OpenDrone-hw/OpenRX-Lite-UFL/(commit log)

2026-03-23 Add SolderPad_1.2x2.0mm with 25% rounded corners, 2.0mm pitch standard
2026-03-23 Import SKY13588-460LF SP3T RF switch (C2151906) into shared library
2026-03-23 Final topology: Mono + Gemini netlist with SKY13588 RF switch
    - SKY13588-460LF imported into shared library
    - Complete netlist for Mono (1×LR1121 + SKY13588 + Johanson IPD + DEA LPF → 1 UFL)
    - Gemini = 2× Mono RF chains + ESP32-C3 True Diversity GPIO mapping
    - GPIO maps match official ELRS Generic C3 LR1121 and True Diversity targets
    - Routing notes for RF paths included
    - Mono needs complete GPIO rewire to match ELRS target
2026-03-23 FINAL_NETLIST v3: SKY13588 as band combiner, RFX2401C kept for 100mW
    Based on RadioMaster XR4 teardown analysis:
    - SKY13588 serves as both sub-GHz path switch AND band combiner
    - Johanson IPD in direct-tie mode (RX/TX_LP/TX_HP joined) → SKY13588 J1
    - 2.4GHz: RFIO_HF → DEA LPF → RFX2401C → SKY13588 J2
    - SKY13588 RFC → DC block → UFL → dual-band antenna
    - RFX2401C kept for 100mW market parity
    - Button imported (C2976675, 3x2mm SMD)
    - RFSW truth table: DIO7/DIO8 control band, DIO5/DIO6 control RFX2401C
2026-03-24 Repo cleanup: final state for handoff
    - Clean README with architecture, BOM, CE notes, status
    - Remove dated analysis files (absorbed into FINAL_NETLIST + KICAD_WORKFLOW)
    - Remove stale OpenRX-Dual (archived), ERC reports, backups, prl files
    - Updated .gitignore for .kicad_dru, production backups
    - CERN-OHL-S v2 license confirmed
    - 3 active projects: Lite, Mono, Gemini
    - Schematics final, initial PCB layouts done, routing in progress
2026-04-06 Update schematics: Mono RF rewiring, SKY13414 port mapping, shared libs
    Mono: disconnect IPD TX_LP (unused by ELRS), route TX_HP→RF3, RX→RF1,
    RFX2401C ANT→RF4. Matches BetaFPV SuperX topology.
2026-04-06 Add Lite-UFL variant, ELRS targets, new footprints and 3D models
    - OpenRX-Lite-UFL: UFL antenna variant of Lite ceramic
    - ELRS target JSONs: Lite 2400, Mono LR1121, Gemini LR1121
    - radio_rfsw_ctrl: [15,0,0,8,8,14,0,13] for Mono/Gemini
    - SKY13414 QFN-14 footprint + 3D model
    - 2450FM07D0034 filter footprint
    - BOM LCSC passives script
    [OpenRX-Lite-UFL.kicad_pcb, OpenRX-Lite-UFL.kicad_sch, esp32c3_sx1281_lite.kicad_sch]
2026-04-06 Add component datasheets and BOM index
    Local datasheet cache for all active RF components: LR1121, SX1281,
    SKY13414, SKY13373, RFX2401C, 2450FM07D0034, 0900PC16J0042001E,
    2000PC15C0040001E, 2450AT18A100E, BALF-SPI2-01D3, passives.
2026-04-06 Update all DESIGN.md docs: RF paths, GPIO maps, rfsw_ctrl, known bugs
    - Mono: new SKY13414 port mapping (RF1=RX, RF3=TX_HP, RF4=2.4GHz),
    rfsw_ctrl [15,0,0,8,8,14,0,13], GPIO map, impedance notes
    - Lite/Lite-UFL: GPIO map, no-boot-button note, SPI pin difference
    - Gemini: document DIO7-2/DIO8-2 wiring bug, stale component list
    - README: current lineup table
2026-04-21 initial routing for all
    [OpenRX-Lite-UFL.kicad_pcb, esp32c3_sx1281_lite.kicad_sch]
2026-04-27 final route
    [OpenRX-Lite-UFL.kicad_pcb]
2026-04-28 Set via netclass + dimension defaults to 0.3/0.2mm on all 4 boards
    [OpenRX-Lite-UFL.kicad_pcb]
2026-04-28 switch to 0.2mm vias
    [OpenRX-Lite-UFL.kicad_pcb]
2026-04-28 gitignore JLC per-quote BOM markdown drops
2026-05-08 OpenRX Lite (UFL + molex)
    [OpenRX-Lite-UFL.kicad_pcb, esp32c3_sx1281_lite.kicad_sch, lite-ufl.step]
2026-06-06 docs: standardized 3D board renders for all RX variants (front/back)
2026-06-07 docs: populate DOC_* text variables for all RX variants
    Set DOC_NAME/HANDLE/VARIANT/TAGLINE/FIRMWARE/PROTOCOL/MCU/INPUT/RATING in
    each variant .kicad_pro, derived from the schematics and ELRS target JSON,
    matching the sibling OpenDrone repos' convention.
2026-06-07 docs: reconcile README against schematics, add DESIGN_NOTES + all-variant renders
    - README rewritten against schematic/netlist ground truth (OpenFC-Lite-Mini-style
    layout, all four variants' front/back renders side-by-side).
    - Corrected antenna roles: AE1 (2450AT18A100E ceramic) is the ESP32-C3 Wi-Fi/OTA
    antenna (net WIFI) on every variant; the ELRS link antenna is FL1-OUT's load —
    47948-0001 chip antenna on Lite, U.FL on Lite-UFL/Mono/Gemini.
    - Pad pinout + per-variant pin map derived from netlists and ELRS target JSON.
    - Corrected: two distinct radio TCXOs (52 MHz SX1281 / 32 MHz LR1121); only Gemini
    has a tactile button; per-variant LED GPIO.
    - DESIGN_NOTES.md mirrors the on-can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
2026-06-07 docs: via-free board renders
    Re-render top/bottom board images with vias removed for a cleaner look.
    KiCad cannot render tented vias, so vias were temporarily stripped via the
    pcbnew API for rendering only; source .kicad_pcb files are unchanged.
2026-06-07 docs: re-render boards without floor shadows
    Re-render top/bottom images at basic quality so the soldermask floor
    shadow halo is gone. Vias still stripped for the render only (via pcbnew),
    source .kicad_pcb files unchanged.
2026-06-07 docs: render boards without solder paste
    Strip the solder-paste layer (and vias) for the render only so SMD pads
    show as clean copper instead of gray paste deposits. Source .kicad_pcb
    files unchanged.
2026-06-07 docs: remove DESIGN_NOTES, trim README boilerplate
    - Delete DESIGN_NOTES.md (and its gitignore exception)
    - Drop the Manufacturing / production-export section
    - Remove the canonical-reference boilerplate blurb
    - ESC boards: AM32 bootloader ships pre-loaded, firmware flashed via am32.ca
2026-08-04 chore: wire shared Incutec KiCad library
    Adds incutec-hw/KiCad-Library as submodule at libs/KiCad-Library, pinned
    to the feat/complete-library build. Project lib tables gain the Incutec
    sym+fp entries via ${KIPRJMOD} relative paths. Existing local libraries
    untouched (frozen, see the library repo MANIFEST).
2026-08-05 shared: refresh QFN-12/QFN-16 footprints, add RFX2401C 3D models
    Footprint editor resave of the two QFN footprints and new
    RFX2401C QFN-16 EP1.7 step/wrl models referenced by Mono and Gemini.
2026-08-05 Lite/Lite-UFL: ELRS target pin remap and RGB LED
    Corrected SX1281 SPI pin map (miso/mosi/sck/dio1/nss) and switched
    from plain LED on GPIO10 to WS2812 RGB on GPIO8, matching the boards.
2026-08-05 docs: adopt OpenDrone repo standard
    README restructured to the standard section order; deep antenna, pad,
    pin-map, and firmware-target detail relocated to a new family DESIGN.md.
    Per-variant DESIGN.md files reconciled against the committed schematics,
    PCBs, and ELRS target JSON: SKY13373-460LF (not SKY13414), current
    radio_rfsw_ctrl values, real Gemini sheet hierarchy and refdes, Lite
    DESIGN.md no longer a copy of the Lite-UFL one. Adds CONTRIBUTING.md,
    AGENTS.md, CHANGELOG.md.
    Fact-check fixes: board sizes at Edge.Cuts centerline, KiCad 10 (not
    9/10), library claim corrected to OpenRX-Shared + Incutec submodule +
    embedded stock footprints, ELRS targets described as in-repo (not
    upstream),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
2026-08-05 chore: track per-variant Fabrication Toolkit config
2026-08-05 changed 3.3V supply on clocks, added text, enlarged pads
    [OpenRX-Lite-UFL.kicad_pcb, OpenRX-Lite-UFL.kicad_sch]
2026-08-06 Rewrite CONTRIBUTING for humans: file locking, render proof, sign-off
    KiCad files cannot be merged, so the doc now leads with claiming files via
    git lfs lock and issue-first discussion, the convention used by LumenPnP and
    Ultimate Hacking Keyboard. Adds .gitattributes marking design files lockable.
    Drops the internal documentation-style rule that meant nothing to contributors.
2026-08-06 Untrack the bench flashing guide
    It documents an internal bench setup and points at a local-only ExpressLRS
    fork, so it is not usable by anyone cloning the repo. Per-board flashing
    guides get written after bringup. File stays on disk.
2026-08-06 Fix contradictions and duplicated information
    Contradictions:
    - Restore shared/libs/OpenRX-Shared.kicad_sym, dropped by accident in 376695b.
    All 7 sym-lib-tables point at it and the schematics carry 20 OpenRX-Shared:
    lib_ids, so a fresh clone could not edit or place any symbol. Restored
    byte-exact from 376695b^.
    - README board sizes now match Edge.Cuts: Lite and Lite-UFL 10.0 x 11.5 mm,
    Mono 10.0 x 17.3 mm. Gemini was already correct at 17.0 x 15.7 mm.
    - Remove the nine dead FLASHING.md links. The file is untracked and gitignored.
    Facts that only lived behind those links are inlined: the LR1121 DIO5-DIO8 to
    RFX2401C/SKY13373 mapping, the ExpressLRS 3.5.0 minimum, and the Mono/Gem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
2026-08-06 Local libraries are the working default again
    New parts go into this repo's local libraries. KiCad-Library becomes a mirror
    of parts we already use or stock, worth checking first because a hit means we
    have sourced it before. Promotion into it is a separate step.
2026-08-11 update all RXs rev2 with fab files
    [OpenRX-Lite-UFL-B_Cu.gbr, OpenRX-Lite-UFL-B_Mask.gbr, OpenRX-Lite-UFL-B_Paste.gbr, OpenRX-Lite-UFL-B_Silkscreen.gbr, OpenRX-Lite-UFL-Edge_Cuts.gbr, OpenRX-Lite-UFL-F_Cu.gbr, OpenRX-Lite-UFL-F_Mask.gbr, OpenRX-Lite-UFL-F_Paste.gbr]
2026-08-12 Add the ExpressLRS logo footprint to the shared library
    Graphics only, no pads, generated by bitmap2component. Marked board_only,
    exclude_from_pos_files and exclude_from_bom, so it stays out of the CPL and the
    BOM. Carries artwork on both F.SilkS and F.Cu; drop the F.Cu polygons after
    placing if silkscreen alone is wanted.
2026-08-12 Rev 2 board work: routing optimisations, logo placement, 3D model fixes
    Routing reworked on Lite (segments 313 to 256, vias 60 to 89), Lite-UFL
    (317 to 269, 61 to 85) and Gemini (682 to 688, 196 to 243). ExpressLRS logo
    placed on Mono.
    3D model fixes on Gemini and Mono:
    - RFX2401C (U4, U7) pointed at QFN-16_L3.0-W3.0-H0.9-P0.50.wrl with an offset
    of (-951.61, 821.31, 0), so the body rendered about a metre off the board and
    the land looked bare in the viewer. Repointed at the RFX2401C model that
    OpenRX-Shared.pretty/QFN-16_L3.0-W3.0-P0.50-BL-EP1.7.kicad_mod specifies,
    offset zeroed, 270 degree rotation kept.
    - SKY13373 (U5, U8) carried no model reference at all. Added, matching the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
    [OpenRX-Lite-UFL.kicad_pcb]
2026-08-13 Standardise: six design docs into one AGENTS.md, trimmed README (#26)
    Adopts the org-wide shape for a multi-variant repo. The root DESIGN.md and the
    four per-variant DESIGN.md files become a single AGENTS.md: the family circuit,
    antennas, pad map, pin map and firmware targets once, then a section per
    variant. Cross-references between the old files become in-document anchors, all
    of which resolve.
    Every variant gains a .kicad_dru carrying the canonical block. Lite and
    Lite-UFL had none at all; Mono and Gemini had a single rule conditioned on a
    "50Ohm" netclass that no project in the org defines, so it could never fire.
    README drops the repository layout, build commands and per-variant detai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
2026-08-13 README: standardised link row, specs from the shop, status badge (#28)
    Same shape in every board repo.
    Outbound links move out of prose into one badge row: status, shop, the product's
    Discord channel, its build video, and OSHWA where the board is certified. The
    status badge links to the stage ladder in the org CONTRIBUTING rather than
    describing the stage here.
    The specification table is synced from the product page on opendrone.be, which
    is the maintained copy for now. Long term this goes the other way.
    "In the line" points at opendrone.be instead of listing sibling repos by hand,
    since what pairs with what changes there first.
    Drops the JustFPV teardown line, now the video badge, and o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
2026-08-14 Normalise board setup to the line standard
    The canonical dru's copper-to-copper rule demanded 0.1 mm outer
    clearance against the 0.09 line standard stated in the same file,
    flooding DRC with false errors on standard-routed boards. Removed;
    the project-file floors gate this already. Rule floors set to the
    line standard where the routed board complies, verified by DRC:
    zero new violations.
2026-08-14 Drop the KiCad-Library submodule: nothing references it
    No symbol, footprint or 3D model in the design resolves through
    libs/KiCad-Library; every part is in the repo's local libraries. The
    submodule only cost --recursive clones and pin maintenance. Lib-table
    rows for the dead Incutec nickname removed so KiCad stops warning.
2026-08-14 Rev 3.1 working state: zone refills, fab option names, ordered sets
    Mono and Gemini PCB zone refills and priority renumbering, Lite-UFL J1
    LCSC field, fabrication-toolkit archive names per revision, the dated
    2026-08-06 production sets for Lite-UFL and Mono as the record of what
    was ordered, competitor RX catalogue, stale export STEPs deleted. The
    repo-specific .gitignore tail restores flashing/bringup notes and the
    firmware handoff bundle to local-only, plus regenerable dumps.
    [OpenRX-Lite-UFL-B_Courtyard.gbr, OpenRX-Lite-UFL-B_Cu.gbl, OpenRX-Lite-UFL-B_Fab.gbr, OpenRX-Lite-UFL-B_Mask.gbs, OpenRX-Lite-UFL-B_Paste.gbp, OpenRX-Lite-UFL-B_Silkscreen.gbo, OpenRX-Lite-UFL-Edge_Cuts.gm1, OpenRX-Lite-UFL-F_Courtyard.gbr]
2026-08-14 Track FLASHING.md, drop the legacy-projects archive from the tip
    FLASHING.md is the per-product flashing and debug reference; people
    cannot use the boards without it, so it is repo content, not a bench
    note. The five superseded designs (44 MB) stay in git history, which is
    what archives are; the tip carries current designs only.
2026-08-14 Rebuild E6 substitute STEP models from the trusted wrl geometry
    The .step files beside these .wrl models were different parts (USB-C
    3.5x oversized, etc), and the upstream LCSC .step is the same wrong
    file, so kicad-cli --subst-models shipped wrong geometry in every STEP
    export while the 3D viewer looked perfect. Rebuilt as tessellated STEP
    solids from the .wrl the viewer renders, via
    OpenDrone-Scripts/kicad/wrl_to_step.py: bbox and origin now match to
    0.000 mm. check_models reports zero E6, export unblocked.
2026-08-14 Lite-UFL J1: LCSC C88374, no leading space, on board and schematic
    The schematic had ' C88374' with a leading space and the board had no
    LCSC field at all, so the U.FL connector silently dropped out of the
    fab BOM: check_export.py C3 caught it (bom 0 < sch 1). Schematic fixed
    by one-string replacement; board field added via the pcbnew API, styled
    like every other hidden LCSC field. Export re-run and verified.
    [OpenRX-Lite-UFL.kicad_pcb, esp32c3_sx1281_lite.kicad_sch]
2026-08-14 Rev 2 refresh prep: renders, schematic PDFs, revisions
    The committed board now matches the verified fab export exactly
    (check_export.py C1-C3 clean). Renders regenerated from it.
2026-08-15 docs: standardise AGENTS.md, complete spec table, fix flash targets
    AGENTS.md rebuilt on the org template and fact-checked against the design files. README spec table completed (telemetry power, dimensions, 1.0 mm PCB for all variants) and maintainer added. FLASHING.md build targets corrected to opendrone.rx_2400.lite / .lite_ufl. DOC text variables cleaned of em dashes.
2026-08-22 3D models: retarget to KiCad stock, fix placement
    Replaces easyeda2kicad 3D models with KiCad's own where a dimension-matched
    equivalent exists. The easyeda models run 20-100x denser for the same package
    and most carry the LCEDA watermark modelled as raised geometry, which renders
    on every CAD picture of the board and is not on the real part.
    Only the (model ...) reference, offset and rotation are touched. No footprint,
    pad, land pattern, net, placement or value is modified. Applied to the footprint
    LIBRARY and the boards together: fixing only the .pretty is invisible because
    each board carries its own footprint copy, and fixing only the .kicad_pcb is
    surface level because the next placemen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
    [OpenRX-Lite-UFL.kicad_pcb]
2026-08-25 sch: standardise LCSC/Manufacturer/MPN fields across all variants
    Migrated LCSC part numbers out of variant-specific LCSC_Part fields into
    the standard LCSC field, and backfilled Manufacturer/MPN from the LCSC
    catalogue, on all four board variants (Gemini, Lite, Lite-UFL, Mono) and
    the shared ESP32-C3/SX1281 RX core sheet.
    kicad-skip reflowed each file on save, so the diffs are large but purely
    formatting; a structural S-expression diff and ERC re-run on all 12
    affected schematics (including the 4 unmodified top-level sheets) confirm
    only property values changed, no nets/placement/footprints touched.
    Known gap: L2/L3 in OpenRX-Gemini/esp32c3_lr1121_gemini.kicad_sch carry
    LCSC C1035, which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
    [esp32c3_sx1281_lite.kicad_sch]
2026-08-31 AGENTS.md: sync from the bench mirror rework (#45)
    Formatting repairs plus verified corrections from the 2026-08-31 bench
    session (fact-checked against datasheets, board READMEs and firmware
    sources). Details per file in OpenDrone-Testing commit 06034b3.
2026-09-01 Adopt shared KiCad datasheets
2026-09-01 Split board into its own hardware repository
    [OpenRX-Lite-UFL-B_Courtyard.gbr, OpenRX-Lite-UFL-B_Cu.gbl, OpenRX-Lite-UFL-B_Cu.gbr, OpenRX-Lite-UFL-B_Fab.gbr, OpenRX-Lite-UFL-B_Mask.gbr, OpenRX-Lite-UFL-B_Mask.gbs, OpenRX-Lite-UFL-B_Paste.gbp, OpenRX-Lite-UFL-B_Paste.gbr]
2026-09-02 Reorder AGENTS.md sections: design first, agent mechanics last
    New order: Architecture, (Voltage envelope,) Power, Key parts, Connectors
    and I/O, (GPIO map, Using it on a base,) Layout rules, Firmware, Repo,
    (Parts and datasheets,) Environment, Rules, Revisions.
    Claude-Session: https://claude.ai/code/session_01GiFxVPcfpNcHY5feGsgG83
2026-09-09 Set the titleblock revision to rev2
    quote_pack.py syncs the titleblock from the release stem; recording it
    keeps the design source stable across exports.
    Claude-Session: https://claude.ai/code/session_01HXA6SP2VEuBZn7yMrez3es
    [OpenRX-Lite-UFL.kicad_pcb]
2026-09-09 Give every placed part an LCSC field
    The BOM exporter reads a field named LCSC. Parts that carried only
    "LCSC Part" were dropped from the supplier BOM and the pick and place
    without a warning, and ESP32-C3, the 15uH DC-DC inductor and
    SKY13373-460LF carried no LCSC anywhere.
    Adds LCSC to the schematic symbols and mirrors it onto the board
    footprints, which is the only route for references created by a
    replicated hierarchical sheet. Numbers verified against the LCSC
    catalogue: ESP32-C3FH4 C2858491, MLZ2012M150WT000 C383402,
    SKY13373-460LF C150853. Bare test pads stay without a part number.
    Claude-Session: https://claude.ai/c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
    [OpenRX-Lite-UFL.kicad_pcb, esp32c3_sx1281_lite.kicad_sch]
2026-10-12 docs(agents): cut AGENTS.md to validate, boundaries, pointers (#4)
    AGENTS.md 161 -> 18 lines. Removes architecture, tables, procedures and
    state; keeps only hard boundaries and the validation command.
    Claude-Session: https://claude.ai/code/session_017Ye54fa9v5VP179Xbw465R
2026-10-13 docs: restore AGENTS.md technical write-up (#6)
    Reverts the AGENTS.md cut and the README pointer change; the write-up is board documentation, not duplicated elsewhere.
    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
2026-11-11 docs(rules): kicad-skip cannot round-trip KiCad 10 schematics (#12)
    Syncs the shared Rules section from OpenDrone-hw/hardware-template (PR 16).
2026-11-12 OSC1: clear the OSC1 Do-not-populate flag the PCB footprint gained in #11 (#13)
    The schematic still has the 52 MHz TCXO fitted with LCSC C22434896; the PCB
    footprint diverged in #11 (DRC schematic parity flags it). The Fabrication
    Toolkit BOM and positions are read from the PCB, so the production pack would
    have left OSC1 unplaced: a radio without its TCXO.
    Metadata only, written with the pcbnew API: no net, track, placement or
    footprint change (track blocks are the same multiset, only reordered by the
    save). DRC counts unchanged; the parity finding is gone.
2026-11-12 Titleblock and Fabrication Toolkit archive name: rev2.3 (#14)
    rev2.3 is the batch 2 production revision (founder decision 12 Nov 2026:
    include the 1 Nov fix). The production adapter sets the titleblock to the
    release revision and stops when that changes the design source, so the
    board must say rev2.3 at the released commit; the archive name follows.
    Metadata only, written with the pcbnew API.
2026-11-14 README: describe OpenRX as a general-purpose radio control receiver module (#15)
    Requested by Stan, 14 Nov 2026: "fix the public readme's".
    - Opening lines: ExpressLRS radio control receiver module with telemetry, for cars, boats, robots and aircraft; technical facts unchanged.
    - Connection: serial (CRSF) on the RX/TX pads to a controller; a flight controller is named as one example.
    - PWM output is not claimed: the shipped ExpressLRS layout for this board defines no `pwm_outputs`, so the web UI offers no PWM channels.
    README text only; no KiCad files touched.
    Founder-session: 2026-11-14: Stan, 14 Nov 2026: "fix the public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
